adrian-jackson/rain_garden_remote_telemetry/firmware/documentation/components/Botletics_SIM7000/note.txt

List of spec overview docs:
https://github.com/botletics/SIM7000-LTE-Shield/tree/master/SIM7000%20Documentation/Spec%20Overview%20Docs

Need to find which version of the board they have. Above github has extensive documentation.

possibly fake doc: 
https://www.espboards.dev/sensors/sim7000/#specs
