adrian-jackson/rain_garden_remote_telemetry/firmware/src/power_monitoring/battery_charge_test.txt

#include <Arduino.h>

int POS_PIN = 1;
int NEG_PIN = 2;

//note down starting time of program!
//assuming voltage divider for positive terminal with 1k and 10kOhm resistor

void setup() {
  pinMode(POS_PIN, INPUT);
  pinMode(NEG_PIN, INPUT);
  Serial.begin(9600);
}

void loop() {
  int raw_pos = analogRead(POS_PIN);
  int raw_neg = analogRead(NEG_PIN);
  int voltage = raw_pos raw_neg;
  Serial.println(voltage);

  delay(1000); //log every 10 mins
}
