adrian-jackson/rain_garden_remote_telemetry/firmware/src/main.cpp

#include <SoftwareSerial.h>
#include <Arduino.h>
#include <api_key.h>
#include <Wire.h>
#include <Adafruit_SHT31.h>

// SENSOR HARDWARE NOTES
/*
Hardware:
- SHT31 (I2C) weatherproof sensor
- Tipping bucket rain gauge (reed switch -> interrupt)
- Grove 10 cm water level sensor, 20 sections (I2C @ 0x78, 0x77)
- Two 0.5–4.5 V pressure transducers (0–30 psi), bottom + atmosphere
Notes:
- Pipe is 4" corrugated HDPE; blending Manning with orifice when near/full.
*/

// ── Pin defs ────────────────────────────────────────────────────────
// Software serial for shield (RX, TX)
SoftwareSerial shieldSerial(10, 11);

// SIM7000 pins
#define PWRKEY 6
#define RST    7

// sensor pins
const uint8_t PIN_RAIN = 2; // interrupt pin for reed switch (UNO: 2 or 3)
const uint8_t PIN_PSI_BOTTOM = A0;
const uint8_t PIN_PSI_AIR = A1;
// ─────────────────────────────────────────────────────────────────────────────

// APN, Dest, Password, Etc
// ── User configuration ────────────────────────────────────────────────────────
#define APN              "hologram"          // ← your SIM card APN
#define SERVER_HOST      "rcewrp-backend-23923596738.us-central1.run.app"       // ← no https://, no trailing slash
#define SERVER_PATH      "/admin/sample"                  // ← endpoint path for POST
#define TEMP_SERVER_HOST "https://rain-garden-remote-telemetry-iiwrfszux-adrianjackson.vercel.app/"
#define TEMP_SERVER_PATH "api/data"
#define TEMP_FLAG 1
#define POST_INTERVAL_MS  1800000               // 30 minutes in ms
#define MODEM_RESTART_INTERVAL_MS  43200000UL   // 12 hours in ms
#define KEEPALIVE_INTERVAL_MS  300000UL         // 5 minutes in ms
// ─────────────────────────────────────────────────────────────────────────────

// ── Consts and Demo Values ──────────────────────────────────────────────────────
const char *API_KEY = ADMIN_PANEL_API_KEY;
const char *TEMP_API_KEY = UPLOAD_TEMP_API_KEY;
const char *uniqueSiteId = "test";
int testSiteID = 103;
int bartleSiteID = 1;
float temp_demo = 1.0;
float inflow_demo = 1.0;
float outflow_demo = 1.0;
float downflow_demo = 1.0;
float humidity_demo = 1.0;
float precipitation_demo = 1.0;
unsigned long lastModemRestartMs = 0;
unsigned long lastKeepaliveMs = 0;
// ─────────────────────────────────────────────────────────────────────────────


// ── Sensing & Hardware  ──────────────────────────────────────────────────────

// General
const float VREF = 5.000; // UNO ADC reference (measure your 5V if you can)
const float ADC_RES = 1023.0;

// Rain gauge windowing
unsigned long WINDOW_SECONDS = 600; // default 10 minutes. Change as needed.
float TIP_SIZE_IN = 0.0100; // inches per tip (change per site)
float DRAINAGE_AREA_AC = 0.25; // acres (change per site)

// Pipe & hydraulics
const float PIPE_DIAM_IN = 4.0; // KEEP at 4.0 for these A/WP formulas
float N_MANNING = 0.021; // corrugated HDPE
float SLOPE_S = 0.010; // ft/ft (1% default; change per site)

// Orifice fallback (pressurized/full pipe)
float CD_ORIFICE = 0.65; // discharge coeff (tune if you can)
const float G_FTPS2 = 32.174; // gravity

// Water level (Grove 10cm, 20 sections)
const uint8_t WL_ADDR_LOW = 0x78;
const uint8_t WL_ADDR_HIGH = 0x77;
const float MAX_HEIGHT_IN = 3.937f; // 10 cm in inches
const int TOTAL_SECTIONS = 20;

// ----------------------- STATE -----------------------

Adafruit_SHT31 sht31;
volatile unsigned long tipCount = 0;
volatile unsigned long lastTipMicros = 0;
const unsigned long TIP_DEBOUNCE_US = 250000UL; // 250 ms debounce
unsigned long windowStartMs = 0;

// ----------------------- UTILS -----------------------

static inline float clampf(float x, float lo, float hi) {
  if (x < lo) return lo;
  if (x > hi) return hi;
  return x;
}

static inline float safe_acos(float x) {
  return acosf(clampf(x, -1.0f, 1.0f));
}

// ----------------------- RAIN ISR -----------------------

void rainISR() {
  unsigned long now = micros();
  if (now - lastTipMicros > TIP_DEBOUNCE_US) {
    tipCount++;
    lastTipMicros = now;
  }
}

// ----------------------- I2C helper for water level -----------------------
uint8_t readSectionByte(uint8_t addr) {
  Wire.beginTransmission(addr);
  Wire.write(0x00); // section count register (per Seeed examples)
  if (Wire.endTransmission(false) != 0) return 0;
  if (Wire.requestFrom(addr, (uint8_t)1) != 1) return 0;
  return Wire.read();
}

// ----------------------- SENSOR READS -----------------------

float readTempF(float &humidity) {
  float tC = sht31.readTemperature();
  humidity = sht31.readHumidity();
  // Handle occasional NaNs:
  if (isnan(tC)){
    tC = 0.0;
  }
  if (isnan(humidity)){
    humidity = 0.0;
  }
  return tC * 9.0f/5.0f + 32.0f;
}

float readWaterLevelY_inches() {
  uint8_t lowSec = readSectionByte(WL_ADDR_LOW);
  uint8_t highSec = readSectionByte(WL_ADDR_HIGH);
  int active = (int)lowSec + (int)highSec;
  active = (int)clampf(active, 0, TOTAL_SECTIONS);
  float pct = (float)active / (float)TOTAL_SECTIONS;
  float y_in = pct * MAX_HEIGHT_IN; // cannot exceed diameter
  return clampf(y_in, 0.0f, PIPE_DIAM_IN);
}

float readVoltage(uint8_t analogPin) {
  int raw = analogRead(analogPin);
  return (raw * VREF / ADC_RES);
}

float psiFromVoltage_0to30(float v) {
  // calibration: 0.5V->0 psi, 4.5V->30 psi
  // slope = 30 / (4.5 - 0.5) = 7.5 psi/V
  float psi = (v - 0.5f) * 7.5f;
  if (psi < 0) psi = 0;
  if (psi > 30) psi = 30;
  return psi;
}

float headFeetFromTwoTransducers(uint8_t pinBottom, uint8_t pinAir) {
  float vB = readVoltage(pinBottom);
  float vA = readVoltage(pinAir);
  float psiB = psiFromVoltage_0to30(vB);
  float psiA = psiFromVoltage_0to30(vA);
  float dPsi = psiB - psiA;
  // 1 ft H2O ≈ 0.433 psi
  return (dPsi / 0.433f);
}

// ----------------------- HYDRAULICS -----------------------

// NOTE: The A(y) and WP(y) formulas provided by you are specific to R = 2 in (D=4 in).

// Units: y in inches; A returned in ft^2; WP returned in ft.

float area_ft2_from_y_in(float y) {
  y = clampf(y, 0.0f, PIPE_DIAM_IN);
  // A = [4*acos((2-y)/2) - (2-y)*sqrt(4y - y^2)] / 144
  float term = (2.0f - y);
  float inside = (4.0f * y - y * y);
  if (inside < 0) inside = 0;
  float A_in2 = 4.0f * safe_acos(term / 2.0f) - term * sqrtf(inside);
  return (A_in2 / 144.0f);
}

float wettedPerimeter_ft_from_y_in(float y) {
  y = clampf(y, 0.0f, PIPE_DIAM_IN);
  // WP = (acos((2-y)/2)) / 3
  float WP_ft = safe_acos((2.0f - y) / 2.0f) / 3.0f;
    if (!isfinite(WP_ft) || WP_ft < 0) WP_ft = 0.0f;
    return WP_ft;
}

float Q_manning_cfs(float y_in) {
  float A = area_ft2_from_y_in(y_in);
  float WP = wettedPerimeter_ft_from_y_in(y_in);
  if (A <= 0 || WP <= 0 || SLOPE_S <= 0 || N_MANNING <= 0){return 0.0f;}
  float R = A / WP;
  return (1.49f / N_MANNING) * A * powf(R, 2.0f/3.0f) * sqrtf(SLOPE_S);
}

float Q_orifice_cfs(float head_ft) {
  if (head_ft <= 0){ 
    return 0.0f;
  }
  float D_ft = PIPE_DIAM_IN / 12.0f;
  float A_full = 3.1415926535f * D_ft * D_ft / 4.0f;
  return CD_ORIFICE * A_full * sqrtf(2.0f * G_FTPS2 * head_ft);
}


// Blend: Manning when <95% full; Orifice when >=100% full; linear blend in between.
float Qout_blended_cfs(float y_in, float head_ft) {
  float D = PIPE_DIAM_IN;
  float y95 = 0.95f * D;
  if (y_in < y95) {
    return Q_manning_cfs(y_in);
  } else if (y_in >= D) {
    return Q_orifice_cfs(head_ft);
  } else {
    float qM = Q_manning_cfs(y_in);
    float qO = Q_orifice_cfs(head_ft);
    float t = (y_in - y95) / (D - y95); // 0..1
    t = clampf(t, 0.0f, 1.0f);
    return qM * (1.0f - t) + qO * t;
  }
}

// Qin from rainfall over the window
float Qin_from_rain_cfs(float precip_in_over_window) {

  // 1 acre-inch = 3630 ft^3
  float vol_cuft = precip_in_over_window * DRAINAGE_AREA_AC * 3630.0f;
  return vol_cuft / (float)WINDOW_SECONDS;
}


void testBaudRate(long baudrate) {
  Serial.print("Testing ");
  Serial.print(baudrate);
  Serial.print(" baud... ");
  
  shieldSerial.end();
  delay(100);
  shieldSerial.begin(baudrate);
  delay(300);
  
  // Send AT
  shieldSerial.println("AT");
  
  unsigned long startTime = millis();
  String response = "";
  
  while (millis() - startTime < 1500) {
    if (shieldSerial.available()) {
      char c = shieldSerial.read();
      response += c;
    }
  }

  
  if (response.indexOf("OK") != -1) {
    Serial.println("✓ FOUND!");
    Serial.println("Response: " + response);
  } else {
    Serial.println("✗ No OK");
    if (response.length() > 0) {
      Serial.print("  Received: ");
      Serial.println(response);
    }
  }
}

void sendCommand(String command, unsigned long timeout) {
  Serial.print("> ");
  Serial.println(command);
  
  shieldSerial.println(command);
  
  unsigned long startTime = millis();
  while (millis() - startTime < timeout) {
    if (shieldSerial.available()) {
      char c = shieldSerial.read();
      Serial.write(c);
    }
  }
  Serial.println();
}

void initModem() {
  pinMode(PWRKEY, OUTPUT);
  digitalWrite(PWRKEY, LOW);
  delay(1000);
  digitalWrite(PWRKEY, HIGH);

  shieldSerial.begin(9600); // already know working baud from earlier testing

  // debug
  sendCommand("AT+CGMR", 1000);
  sendCommand("AT+CSSLCFG=\"sslversion\",1,3", 1000);

  sendCommand("AT", 1000);
  sendCommand("AT+GSN", 1000);
  sendCommand("AT+CFUN=1", 1000);

  // --- TEARDOWN (ignore errors on all of these) ---
  sendCommand("AT+HTTPTERM", 1000);
  sendCommand("AT+SAPBR=0,1", 1000);
  sendCommand("AT+CGATT=0", 3000);

  // enable GPRS
  sendCommand("AT+CGATT=1", 5000);
  sendCommand("AT+SAPBR=3,1,\"CONTYPE\",\"GPRS\"", 1000);
  sendCommand("AT+SAPBR=3,1,\"APN\",\"hologram\"", 1000);
  sendCommand("AT+SAPBR=1,1", 10000);

  sendCommand("AT+CREG?", 1000);
  sendCommand("AT+CGREG?", 1000);
  sendCommand("AT+SAPBR=2,1", 1000);
  sendCommand("AT+CSQ", 1000);
}

void sendHTTPPost(const char* url, const char* body, bool temp = false) {
    int bodyLen = strlen(body);
    char buf[256];

    sendCommand("AT+HTTPSSL=1", 1000);

    // init HTTP
    sendCommand("AT+HTTPINIT", 1000); //If AT+HTTPACTION=1 returns a non-200 or a connection error dig into SSL config rather than debug the server side.
    sendCommand("AT+HTTPPARA=\"CID\",1", 1000);
    sendCommand("AT+HTTPPARA=\"SSLCFG\",1", 1000);    //use correct SSL config

    snprintf(buf, sizeof(buf), "AT+HTTPPARA=\"URL\",\"%s\"", url);
    sendCommand(buf, 1000);

    sendCommand("AT+HTTPPARA=\"CONTENT\",\"application/json\"", 1000);

    if(!temp){
        // Add custom Authorization header        
        snprintf(buf, sizeof(buf), "AT+HTTPPARA=\"USERDATA\",\"X-API-Key: %s\"", API_KEY);    
        sendCommand(buf, 1000);
    } else {
        // Add custom Authorization header        
        snprintf(buf, sizeof(buf), "AT+HTTPPARA=\"USERDATA\",\"X-API-Key: %s\"", TEMP_API_KEY);    
        sendCommand(buf, 1000);
    }

    // load body — 10000ms window to input data
    snprintf(buf, sizeof(buf), "AT+HTTPDATA=%d,15000", bodyLen); 
    // if issues, can try snprintf(buf, sizeof(buf), "AT+HTTPDATA=%d,15000", bodyLen + 2); to account for crlf
    sendCommand(buf, 1000);          // modem responds with DOWNLOAD
    sendCommand(body, 3000);         // send body, wait for OK

    // fire POST and read response
    sendCommand("AT+HTTPACTION=1", 15000);   // 1 = POST
    sendCommand("AT+HTTPREAD", 15000);

    // teardown
    sendCommand("AT+HTTPTERM", 1000);
    //sendCommand("AT+SAPBR=0,1", 1000); #keep bearer alive - consider doing full teardown for power saving

}


String buildJSON(int siteID, float humidity, float temp_f, float precipitation, float Qin, float Qout, float Qinf)
{
  String json = "{";
  json += "\"siteId\":" + String(siteID) + ",";
  json += "\"temp_f\":" + String(temp_f, 2) + ",";
  json += "\"inflow\":" + String(Qin, 6) + ",";
  json += "\"outflow\":" + String(Qout, 6) + ",";
  json += "\"downflow\":" + String(Qinf, 6) + ",";
  json += "\"humidity\":" + String(humidity, 2) + ",";
  json += "\"precipitation\":" + String(precipitation, 4);
  json += "}";

  return json;
}

void setup() {

  // ── Sensor Setup  ──────────────────────────────────────────────────────

  Serial.begin(9600);

  Wire.begin();
  // SHT31 init: try 0x44 then 0x45
  if (!sht31.begin(0x44)) {
    if (!sht31.begin(0x45)) {
      Serial.println(F("SHT31 not found! (0x44/0x45)"));
    }
  } else {
    Serial.println(F("SHT31 ready"));
  }
  pinMode(PIN_RAIN, INPUT_PULLUP);
  attachInterrupt(digitalPinToInterrupt(PIN_RAIN), rainISR, FALLING);
  windowStartMs = millis();
  Serial.println(F("SHT 31 initialized."));

  // ───────────────────────────────────────────────────────────────────────

  // ── SIM7000 Setup  ──────────────────────────────────────────────────────
  pinMode(PWRKEY, OUTPUT);
  digitalWrite(PWRKEY, LOW);
  delay(1000);
  digitalWrite(PWRKEY, HIGH);
  
  Serial.println("\n=== SIM7000 Baud Rate Scanner ===\n");
  
  long baudRates[] = {9600, 19200, 38400, 57600, 115200, 230400};

  int numRates = sizeof(baudRates) / sizeof(baudRates[0]);
  if(true){
    for (int i = 0; i < numRates; i++) {
      testBaudRate(baudRates[i]);
      delay(500);
    }
    Serial.println("\n=== Scan Complete ===\n");
  }

  if (false){
    shieldSerial.begin(9600);
  }
  
  Serial.println("\n=== Setup Complete ===\n");
  shieldSerial.begin(115200);
  Serial.println(F("[MODEM] Configuring baud rate..."));
  shieldSerial.println("AT+IPR=9600");
  delay(100);
  shieldSerial.begin(9600);

  initModem();
  lastModemRestartMs = millis();
  lastKeepaliveMs = millis();

  // ───────────────────────────────────────────────────────────────────────


}

void loop() {

    // Periodic full modem restart (defends against silent bearer/registration drift)
  if (millis() - lastModemRestartMs >= MODEM_RESTART_INTERVAL_MS) {
    Serial.println(F("[MODEM] 12h elapsed — forcing full restart"));
    initModem();
    lastModemRestartMs = millis();
    lastKeepaliveMs = millis();
  }

  // Lightweight keepalive to reset carrier idle timers between posts
  if (millis() - lastKeepaliveMs >= KEEPALIVE_INTERVAL_MS) {
    sendCommand("AT+CSQ", 1000);
    lastKeepaliveMs = millis();
  }

  // 1) Read temp/humidity
  float humidity = 0.0f;
  float temp_f = readTempF(humidity);

  // 2) Read water level -> y (in)
  float y_in = readWaterLevelY_inches();

  // 3) Read pressure head (ft)
  float head_ft = headFeetFromTwoTransducers(PIN_PSI_BOTTOM, PIN_PSI_AIR);

  // 4) Compute Qout (blended)
  float Qout = Qout_blended_cfs(y_in, head_ft);

  // 5) Windowing for rain/Qin/Qinf
  float precipitation = 0.0f; // inches over window
  float Qin = 0.0f;
  float Qinf = 0.0f;
  unsigned long now = millis();
  if (now - windowStartMs >= WINDOW_SECONDS * 1000UL) {
    noInterrupts();
    unsigned long tips = tipCount;
    tipCount = 0;
    interrupts();
    precipitation = tips * TIP_SIZE_IN; // inches in last window
    Qin = Qin_from_rain_cfs(precipitation); // cfs from rain
    Qinf = Qin - Qout; // cfs
    if (Qinf < 0){
      Qinf = 0; // clamp infiltration to zero
    } 
    windowStartMs = now;
  }

  // Keep modem connection alive and monitor serial
  if (shieldSerial.available()) {
    String response = shieldSerial.readStringUntil('\n');
    Serial.print("< ");
    Serial.println(response);
  }
  
  // Send AT every 5 seconds to keep connection active
  static unsigned long lastCheck = 0;
  if (millis() - lastCheck > POST_INTERVAL_MS) {

    lastCheck = millis();
    
    String json = buildJSON(
      testSiteID,
      humidity,
      temp_f,
      precipitation,
      Qin,
      Qout,
      Qinf
    );

    sendHTTPPost(TEMP_SERVER_HOST TEMP_SERVER_PATH, json.c_str(), true);
    //sendHTTPPost("http://rcewrp-backend-23923596738.us-central1.run.app/upload", json.c_str(), false);

  }
  delay(200);

}
