adrian-jackson/rain_garden_remote_telemetry/(commit log)

2026-03-03 battery testing scripts
2026-03-09 add arduino scripts
2026-03-09 add pioarduino for arduino code execution
2026-03-12 sim7000 and battery testing
    [battery_voltage_log_1773328493.6411262.csv]
2026-03-13 doc and update SIM7000 testing script
    [battery_voltage_log_1773332727.5210156.csv]
2026-04-11 implement TCP socket over IP
2026-06-01 updates etc
    [dump.txt]
2026-07-23 stop tracking unnecesary files
    [battery_voltage_log_1773328493.6411262.csv, battery_voltage_log_1773332727.5210156.csv, dump.txt]
2026-07-27 add server filestructure for temp data hosting
    [dump.txt]
2026-07-27 firmware fixes and vercel config
    [main.cpp]
2026-07-29 bug fixes, keepalive, restart in case of closed PDP context, import SHT31 lib fix
    [main.cpp]
